finnwilson02/handsfree-wheelchair-controller/README.md

# handsfree-wheelchair-controller
A prototype for a head-mounted wheelchair controller using Arduino, allowing people with quadriparesis or quadriplegia to navigate without the need for a carer.
